CITROMOSEPER/4-zone-irrigation-system-2026-TDK-Project/1000030846.jpg

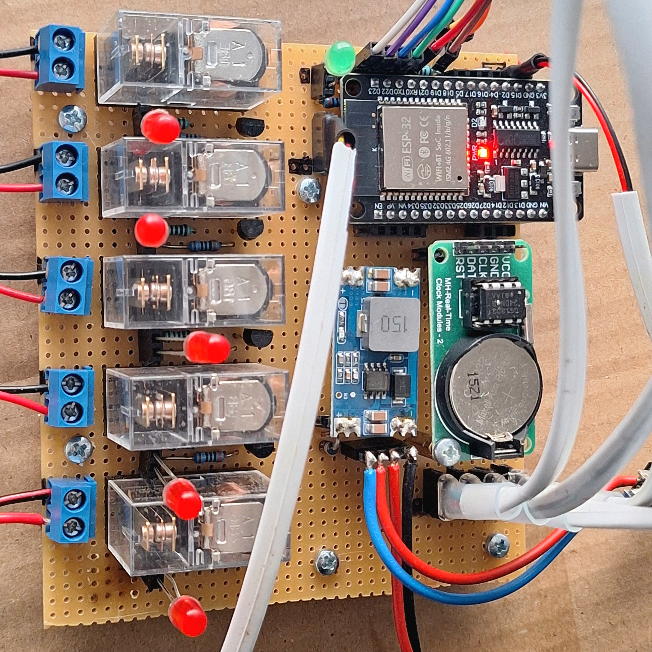
1000030846.jpg
