CITROMOSEPER/4-zone-irrigation-system-2026-TDK-Project/TDK_tesztjegyzokonyv_ND_NyB.docx

Klímaváltozásra felkészített, adatvezérelt öntözőrendszer
1. | 1. kiegészítő dokumentum: Tesztjegyzőkönyv - Automatikus (PC-s) tesztek - Kalibráció és előkészítés - Funkcionális tesztek a maketten - Vízfelhasználási összehasonlító mérés
Szerzők: | Nemes Dániel, Nyul Balázs
NEPTUN kód: | YPWUJV, IW7EV3
Mérés időpontja: | 2026. 11. 06–07.
Konzulens: | Sándor Tamás

# 1. A mérés célja

A jegyzőkönyv a dolgozat 11. fejezetében leírt vizsgálatok elvégzéséhez és dokumentálásához készült. Célja annak igazolása, hogy a végleges (1.3.2) firmware a maketten a tervezett módon működik, valamint mért adatot adni a fix időzítésű és az adaptív öntözés vízfelhasználásáról.

Kitöltés: minden üres cellába a mért vagy megfigyelt adat kerül, a jelölőnégyzetek kattintással pipálhatók. Az egyes tesztek elvárt értékei a firmware forráskódjából származnak. A kitöltött eredmények a 7. fejezet táblázata szerint vihetők át a dolgozatba.

Jelölés: a piros színnel jelölt lépések, sorok és mérések a firmware 1.3.2 változatánál vagy a konferencia-dolgozathoz nem relevánsak, illetve nem készültek el; kitöltésük nem szükséges.

# 2. A méréshez felhasznált eszközök

Eszköz | Típus / azonosító
Vezérlő (ESP32 fejlesztőlap) | ESP-WROOM32-CH340-USB-C
Firmware verziója | 1.3.2 (Config.h); build dátuma:
NYÁK-változat
Digitális multiméter | UNI-T UT33D
Stopper / időmérés módja | telefonnal
Mérőedény (térfogat, pontosság) | a tartály maga: Ø 21 cm hengeres vödör, szint vonalzóval (±1 mm ≈ ±0,035 L)
Tartály (méret, keresztmetszet) | vödör, Ø 21 cm, A ≈ 346,4 cm²; HC-SR04 a fenék felett 17,6 cm-re
Szivattyú, szelepek típusa | DC
Telefon / böngésző | Android, Chrome
Wi-Fi router | EAP610
PC soros terminál (115 200 baud)

## 2.1. A makett kiépítése

A NYÁK és a végleges firmware lábkiosztása a dolgozat 7.6. alfejezete szerint eltér, ezért a tesztek előtt rögzíteni kell a tényleges bekötést.

Jel | PINS.h szerint | A maketten ténylegesen
Szivattyú | önálló GPIO13 | PINS.h szerint (önálló GPIO13)
Szelepek | PINS.h szerinti kimenetek | PINS.h szerint (GPIO19, 18, 17, 16)
Nyomógomb | GPIO4, nyomva magas | PINS.h szerint (GPIO4)
Esőérzékelő | jel: GPIO5, táp: GPIO14 | GPIO5 / GPIO14; modul nincs beépítve, jel szimulálva
HC-SR04 | TRIG GPIO27, ECHO GPIO26 | PINS.h szerint (TRIG GPIO27, ECHO GPIO26)
Talajszenzorok tápja | a szenzor tápellátása biztosított | biztosított (jel: GPIO36, 39, 34, 35)

Megvalósítás: | ☐ NYÁK-revízió ☐ huzalozott módosítás ☐ próbapanel

# 3. Előkészítés és kalibráció

## 3.1. Beállítások

Az alábbi értékek a firmware alapértékei. Ha a mérés során más érték van érvényben, azt a „Használt” oszlopba kell írni.

Beállítás | Alapérték | Használt
Fagyhatár | 2 °C | 2 °C
Zónánkénti minimumhőmérséklet | 4 °C | 4 °C
Napi zónakeret | 90 perc | 90 perc
Esőtiltás küszöbe | 2 mm | 2 mm
Várakozási idő | 120 perc | 120 perc
Térfogatáram (zónánként) | zónánként, a szórófej-előbeállításból | 1,07 / 0,62 / 0,80 / 0,96 L/perc
Tartály: üres / tele távolság | 72 / 8 cm | 16 / 2 cm
Talajszenzor: száraz / nedves nyers érték | 2800 / 1200 | 1300 / 1070 (közös)

Zónák paraméterei

Paraméter | 1. zóna | 2. zóna | 3. zóna | 4. zóna
Név / növény | Gyep | Gyep | Gyep | Gyep
Üzemmód | Érzékelő alapú | Időjárás alapú | Ütemezett | Érzékelő alapú
Kc | 0,95 | 0,95 | 0,95 | 0,95
Gyökérmélység Zr (cm) | 20 | 20 | 20 | 20
FC / WP (%) | 45 / 10 | 45 / 10 | 45 / 10 | 45 / 10
q (L/perc) / R (mm/h) | 1,07 / 50 | 0,62 / 50 | 0,80 / 50 | 0,96 / 50
η (%) | 100 | 100 | 100 | 100
lo / hi (%) | 60 / 95 | 60 / 95 | 60 / 95 | 60 / 95

## 3.2. A térfogatáram kimérése

Áramlásmérő nincs, a napló litere a szivattyúidő és ennek az értéknek a szorzata, ezért ezt kell először elvégezni.

1. A kiválasztott zóna kifolyását vezesd mérőedénybe.
2. A soros terminálon nyomd meg a zóna számát (1–4). Ez pontosan 60 s szivattyúidejű futást indít.
3. A futás végén olvasd le a térfogatot, és számold ki a térfogatáramot. Ismételd meg háromszor.
4. Az átlagot zónánként írd be a zóna öntözőfej-beállításainál (térfogatáram, L/perc); a terület megadásával a felület kiszámolja az R öntözési intenzitást.

, q=(60⋅V)/t [L/perc]#(1)

Zóna | 1. mérés V (L) | 2. mérés V (L) | 3. mérés V (L) | t (s) | Átlag q (L/perc)
1. | 0,987 | 1,004 | 1,004 | 56 | 1,07
2. | 0,571 | 0,485 | 0,693 | 56 | 0,62
3. | 0,797 | 0,814 | 0,641 | 56 | 0,80
4. | 0,901 | 0,918 | 0,883 | 56 | 0,96

Megjegyzés: V a tartály szintcsökkenéséből: V = A·Δh, A = π·(10,5 cm)² ≈ 346,4 cm². A futások 56 s szivattyúidővel készültek, ezért t = 56 s. Az 1. és a 4. zóna mérései 2–4 %-on belül egyeznek. A 2. (0,61 / 0,52 / 0,74 L/perc) és a 3. zóna (0,85 / 0,87 / 0,69 L/perc) szór, de a kettő együttes szintcsökkenése mindhárom futásban közel állandó (3,95 / 3,75 / 3,85 cm), ezért a szórás a köztük lévő leolvasásból ered.

## 3.3. A talajszenzorok kalibrálása

A nedves pontot szántóföldi vízkapacitáson (átáztatott, lecsepegett talajban), a száraz pontot hervadáspont közelében kell felvenni. A nyers érték a /health oldal soil raw mezőjében olvasható, és a sorrend fordított: a nagyobb érték a szárazabb talaj. A szenzoronkénti, hervadáspont közeli kalibráció időhiány miatt elmaradt: a négy szenzor közös kalibrációval fut (száraz 1300, nedves 1070). Az ellenőrző oszlop a talajban mért nyers értéket, zárójelben a levegőben és vízben (a jelölt vonalig) mért értéket mutatja; ezek alapján mind a négy szenzor ép, és egymástól kb. 80 egységen belül egyezik.

Zóna | Száraz pont (nyers) | Nedves pont (nyers) | Ellenőrző pont: nyers / % | Beírva a felületen
1. | 1300 | 1070 | 1115 (levegő 3202, víz 1082) | ☒ igen
2. | 1300 | 1070 | 1126 (levegő 3273, víz 1081) | ☒ igen
3. | 1300 | 1070 | 1121 (levegő 3277, víz 1004) | ☒ igen
4. | 1300 | 1070 | 1136 (levegő 3198, víz 1081) | ☒ igen

## 3.4. A tartályszint ellenőrzése

A tartályszintet a térfogatáram-mérés első sorozatának vonalzós vízszintjeivel ellenőriztük. Kézzel mért távolság = 17,6 cm − h (az érzékelő magassága a tartály aljától, mínusz a vízszint); a kijelzett szint a Statisztika tartálygörbéjéről leolvasva (kb. ±2 %), a kijelzett távolság ebből: 16 − 0,14 · szint. A HC-SR04 3 cm-nél közelebb pontatlan, ezért a „tele” távolság legalább 3 cm legyen.

Szint | Kézzel mért távolság (cm) | Kijelzett távolság (cm) | Kijelzett szint (%) | Eltérés (cm)
h = 10,1 cm | 7,50 | 7,74 | 59 | 0,24
h = 7,25 cm | 10,35 | 10,40 | 40 | 0,05
h = 5,1 cm | 12,50 | 12,64 | 24 | 0,14

Tartály keresztmetszete A (cm²): | 346,4 (Ø 21 cm)
1 cm szintváltozás térfogata (L): | 0,346
Érzékelő magassága a tartály aljától (cm): | 17,6

## 3.5. Kimenetek és alapjelek ellenőrzése

A Rendszerállapot oldal kimeneti tesztjeivel egyenként ellenőrizhetők a kimenetek. A szelepteszt 60 s-ig tart, a szivattyú önmagában (zárt szelepekkel) 3 s-ig fut, a LED-teszt 3 s, a zümmer a vezérlő összes hangját lejátssza.

Kimenet | Megfelelt | Megjegyzés
1. szelep | ☒ igen | ok
2. szelep | ☒ igen | ok
3. szelep | ☒ igen | ok
4. szelep | ☒ igen | ok
Szivattyú nyitott szeleppel | ☒ igen | ok
Hiba-LED | ☒ igen | ok
Zümmer | ☒ igen | ok

Jel | Vezérlő szerint | Referencia | Eltérés
Levegő hőmérséklete (°C) | 21,1 | 20,5 | 0,6
Páratartalom (%) | | | nem használja döntés
Óra (RTC, helyi idő) | | | Automatikusan beállítja magát

# 4. Automatikus tesztek

A firmware PC-re is lefordítható, a hardvert csonkok helyettesítik. Az 1.3.2 készlet 403 ellenőrzést tartalmaz (köztük egy valódi Open-Meteo válasz feldolgozását), a webes felület böngészős tesztjei további 321-et (test/ui/run.sh). A futtatáshoz g++ és POSIX-környezet kell (Linux, WSL vagy Git Bash). A parancsokat a firmware gyökérmappájából kell indítani:

git clone --depth 1 -b v7.4.2 https://github.com/bblanchon/ArduinoJson.git /tmp/aj

test/host/build.sh /tmp/aj/src

A program utolsó sora N checks, M failed formátumú. Hiba esetén a log tartalmát is kiírja.

Futtatás dátuma | 1.3.2 kódellenőrzés (docs/code-review-1.3.2.md)
Környezet, g++ verzió | PC, g++, gnu++17 host build; Chromium (böngészős tesztek)
Ellenőrzések száma (N) | 403 (+ 321 böngészős)
Sikertelen ellenőrzések (M) | 0 (böngészős: 0)
Sikeres / összes | 403 / 403 (321 / 321)
Sikertelen ellenőrzések leírása | –

A tesztek nem fedik le a valós érzékelőidőzítést, a Wi-Fi-t, a HTTPS-kapcsolatot és a flash kopását. Ezeket az 5. fejezet próbái vizsgálják, a flash kopását ez a jegyzőkönyv nem.

# 5. Funkcionális tesztek

A tesztek sorrendje és neve megegyezik a dolgozat 14. táblázatával. Általános szabályok:

- Teszt előtt nézd meg a /health oldalt (soros terminálon a p billentyű): az óra legyen érvényes, a tartály ok, ne legyen output faults.
- Naptári bejegyzést a pontos idő után legalább 2 perccel vegyél fel. A futás legalább 60 s legyen.
- A naplósorok az Előzmények nézetben vagy a havi /log/ÉÉÉÉ-HH.csv fájlokban olvashatók, mezőik: utc, local, zone, mode, soil0, soil1, sec, litres, result.
- A kihagyott futás result mezője SKIP_<ok> alakú. Teszt után a s billentyű minden futást leállít, az x törli a reteszelt hibát.
- Teszt közben a vezérlőt és a tápot tartsd távol a kifolyó víztől.

## 5.1. Beállító portál első indításkor

Elvárt: a setup hálózat elindul, a portál megjelenik, a hálózat menthető, és az oldal kiírja a vezérlő IP-címét. Hibás jelszót néhány másodpercen belül jelez, és megtartja az előző hálózatot (1.3.2).

1. Indítsd a vezérlőt mentett hálózat nélkül, vagy tartsd nyomva a gombot indításkor. A hálózatváltás a felületről is kérhető.
2. Figyeld a hiba-LED lágy „lélegző” jelzését.
3. Csatlakozz telefonnal az Irrigation-Setup-XXXX nyílt hálózatra (a beállítóoldal címe 10.73.0.1). A beállítólapnak maga elé kell ugrania, és listáznia kell a környező hálózatokat.
4. Válaszd ki a hálózatot, add meg a jelszót, és mentsd. A vezérlő a setup hálózat fenntartása mellett csatlakozik (AP+STA): az oldal a Csatlakozás → Csatlakozva → Majdnem kész lépéseket és a kapott IP-címet mutatja.
5. Nyomd meg a Tovább gombot, majd nyisd meg a megjelenő címet vagy az irrigation.local címet.
6. Ismételd meg szándékosan hibás jelszóval: az oldalnak néhány másodpercen belül hibát kell jeleznie, és a korábbi hálózatnak meg kell maradnia.

Megfigyelés | Érték
Hozzáférési pont neve | Irrigation-Setup-XXXX
Bekapcsolástól a hálózat megjelenéséig (s)
A portál automatikusan megjelent (telefon típusa) | Windows 11 és Apple eszközök: igen; Samsung (Android): nem, a címet kézzel kellett beírni
Mentéstől a „Csatlakozva” lépésig (s) | kb. 0,5
Az oldalon kijelzett IP-cím | 10.190.135.145 (telefonos hotspot)
irrigation.local elérhető | igen
Hibás jelszó jelzéséig (s); előző hálózat megmaradt | kb. 0,5; igen

Eredmény: | ☒ Megfelelt ☐ Részben ☐ Nem felelt meg
Megjegyzés: | Minden lépés kb. 0,5 s-os várakozással, hiba nélkül lezajlott. Windows 11-en és Apple eszközökön a portál automatikusan megnyílt, Samsung Androidon a 10.73.0.1 címet kézzel kellett beírni. A vezérlő telefonos hotspotra csatlakozott (http://10.190.135.145/).
Dátum, végezte: | 2026. 11. 07.

## 5.2. Ütemezett öntözés

Elvárt: a szelep nyit, majd 1,5 s után a szivattyú indul, a futás naplózódik. Leálláskor a szivattyú áll le először, a szelep 1,5 s-mal később zár. A sec mező a tényleges szivattyúidő.

1. Egy zónát állíts Ütemezett módba, és vegyél fel egyszeri bejegyzést 120 s hosszal.
2. Figyeld meg, hogy a szelep nyit előbb, és a szivattyú csak utána indul; leálláskor fordítva. A késleltetés értékét a firmware rögzíti (Config.h: PUMP_START_DELAY_MS és VALVE_CLOSE_DELAY_MS = 1500 ms).

A késleltetés értéke a kódban rögzített, ezért külön időmérés és ismétlés nem szükséges; a sorrendet a host-tesztek is ellenőrzik.

3. Írd ki a futás naplósorát.

Ha a makett az eredeti NYÁK-on fut, ahol a szivattyúrelét a szelepjelek diódás VAGY-kapcsolata hajtja, a késleltetés nem érvényesül. Ezt a megjegyzésben rögzítsd.

Mérés | Szelep nyit → szivattyú indul (s) | Szivattyú áll → szelep zár (s) | Futásidő (s)
1. | 1,5 (Config.h) | 1,5 (Config.h) | 120
2.
3.

Késleltetés forrása: | a firmware rögzített értéke (Config.h), a sorrend szemrevételezéssel ellenőrizve

utc | local | zone | mode | soil0 | soil1 | sec | litres | result

Eredmény: | ☒ Megfelelt ☐ Részben ☐ Nem felelt meg
Megjegyzés:
Dátum, végezte: | 2026. 11. 07.

## 5.3. Esőtiltás (érzékelő és előrejelzés)

Elvárt: az ütemezett és az időjárás alapú zóna kihagyja a futást, a napló SKIP_RAIN sort tartalmaz. Az 1.3.2-től az előrejelzés alapú tiltás a következő 24 óra csapadékán alapul, és csak akkor tilt, ha a DWD ICON és az ECMWF modell is eléri a küszöböt. Letakart zónát és visszacsatolásos zónát az eső nem tilt.

1. Érzékelő: nedvesítsd meg az érzékelőt. A mintavétel 30 s-onként fut, két egyező minta váltja az állapotot, ezért legfeljebb kb. 1 perc múlva a /health oldal rain sensor: WET állapotot mutat. Esőérzékelő-modul nélkül a jel szimulálható: GPIO5 → GND átkötés (legalább 60 s-ig).
2. Vegyél fel bejegyzést egy Ütemezett zónára, és várd meg az időpontot.
3. Előrejelzés: száraz érzékelővel olyan napon, amikor a következő 24 órára mindkét modell eléri a küszöböt, ismételd meg a bejegyzést. Szükség esetén a Beállításokban csökkentsd a küszöböt (legkisebb 0,1 mm), és a teszt után állítsd vissza.
4. Nedves érzékelővel ismételd meg letakart jelölésű zónára, majd visszacsatolásos zónára.

Eset | Mai előrejelzés (mm) | Érzékelő | Napló result mezője | Megfelelt
Ütemezett, érzékelő nedves | | szimulált nedves | SKIP_RAIN | ☒ igen
Ütemezett, előrejelzés | | | | ☐ igen
Időjárás alapú, érzékelő nedves | | | | ☐ igen
Letakart zóna, érzékelő nedves | | szimulált nedves | lefutott | ☒ igen
Visszacsatolásos, érzékelő nedves | | | | ☐ igen

Eredmény: | ☒ Megfelelt ☐ Részben ☐ Nem felelt meg
Megjegyzés: | Esőérzékelő-modul nincs beépítve: a jel szimulálva (GPIO5 → GND). Az előrejelzés alapú tiltás és az időjárás alapú zóna esete nem mért.
Dátum, végezte: | 2026. 11. 07.

## 5.4. Visszacsatolásos adag

Elvárt: lo felett nem indul (SKIP_WET), lo alatt a számolt ideig fut. A futásidő 1 s-os lépésekben számolódik, legalább 2 s, legfeljebb 3600 s; ha R nagyobb a beszivárgásnál, a futás szakaszokra bomlik (cycle and soak).

, t_(sz) =((hi-S)⋅TAW)/100⋅100/η⋅3600/R [s]#(2)

, TAW=(FC-WP)/100⋅Z_r ⋅10 [mm]#(3)

Ellenőrző példa (a host-teszt esete): TAW = 22,5 mm, 33%-os talaj, hi = 50%, η = 70%, R = 20 mm/h esetén a futásidő 984 s. A maketten R = 60·q / A (mm/h) a zóna térfogatáramából és területéből adódik.

1. Állíts be egy visszacsatolásos zónát. A talaj legyen lo felett, vegyél fel bejegyzést, és jegyezd fel az eredményt.
2. Száradjon a talaj lo alá (vagy használj szárazabb mintát), és olvasd le a talajnedvességet az időpont előtt.
3. Számold ki a várt futásidőt, majd hasonlítsd össze a napló sec mezőjével.
4. A futás után 10 perccel olvasd le újra a talajnedvességet. Ha az emelkedés kisebb 2 százalékpontnál, a firmware ezt hibaként számolja, és három egymás utáni eset után ütemezett hosszra vált.

Eset | S (%) | lo / hi (%) | TAW (mm) | tsz (s) | Napló sec (s) | result | S 10 perc múlva (%)
lo felett | | 60 / 95 | 70 | | | SKIP_WET
lo alatt, 1. | | 60 / 95 | 70 | | | nem érte el
lo alatt, 2. | | 60 / 95 | 70 | | | nem érte el

Eredmény: | ☐ Megfelelt ☒ Részben ☐ Nem felelt meg
Megjegyzés: | A lo feletti esetben a futás elmaradt (SKIP_WET). A talaj a mérés alatt nem száradt lo (60 %) alá, ezért a lo alatti adag a maketten nem volt mérhető; a dózisképletet a host-teszt ellenőrzi (984 s). TAW = (45 − 10) / 100 · 20 · 10 = 70 mm; η = 100 %, R = 50 mm/h, a várt futásidő t = (95 − S) · 50,4 s. A szakaszos (cycle and soak) öntözés szakaszai a számolt értékekkel futottak le.
Dátum, végezte: | 2026. 11. 07.

## 5.5. Tartályhiány öntözés közben

Elvárt: leállás, hibajelzés, sor törlése. A szint 10% alá esése után kb. 1 s-on belül (öt mérés mediánja; visszhang nélkül 5 s után) a tartály alacsony állapotú, a szivattyú azonnal leáll, a szelep 1,5 s múlva zár. Rendben állapot csak 15% felett.

1. Két zónára vegyél fel azonos percre eső bejegyzést: az első fut, a második a sorban vár.
2. Az első futás közben idézd elő a hiányt: a futást kb. 14%-os szintről indítsd (ennél a makettnél kb. 3,5 cm víz), és hagyd, hogy a szivattyú 10% alá szívja; vagy emeld meg az érzékelőt.
3. Mérd a reakcióidőt, és figyeld a LED-et, a zümmert és a felületet.
4. Gombnyomással némítsd a jelzést. Állítsd vissza a szintet, és ellenőrizd a visszaállást.

Megfigyelés | Érték
A hiány előidézésének módja | szenzor elfordítása
Hiány kezdetétől a szivattyú leállásáig (s) | 5,6 (jelsimítás miatt)
Szivattyú leállásától a szelep zárásáig (s)
Hibajelzés (LED, zümmer, felület) | megtörtént
Gombnyomás némított | igen
Szint helyreállításától az ok állapotig (s) | 1

Várt naplósorok: az első zóna futása TANK_LOW eredménnyel, a második zónáé SKIP_TANK_LOW, valamint riasztási sor.

utc | local | zone | mode | soil0 | soil1 | sec | litres | result
| 22:55 | 3 | ütemezett | 94 | 100 | 20 | 0,27 | leállt: kevés a víz

Eredmény: | ☒ Megfelelt ☐ Részben ☐ Nem felelt meg
Megjegyzés: | Az érzékelő elfordításával nincs visszhang: a firmware a rövid kieséseket kiszűri, és 5 s visszhang nélküli idő után jelez alacsony szintet, így a mért 5,6 s a várt érték.
Dátum, végezte: | 2026. 11. 07.

## 5.6. Szenzor lecsatlakoztatása

Elvárt: hibajelzés, ütemezett hosszra váltás. A 100 alatti vagy 4000 feletti nyers érték hibának számít. A riasztás 60 s fennállás után kerül a naplóba, SOIL kóddal.

1. Egy visszacsatolásos zónára vegyél fel 120 s hosszú bejegyzést.
2. Húzd ki a zóna talajszenzorának jelvezetékét a vezérlő oldalán, és olvasd le a nyers értéket a /health oldalon. Ha nem esik a hibatartományba, ezt mindenképpen jegyezd fel, mert akkor a firmware a szakadást nem ismeri fel.
3. Várd meg a bejegyzést: a zónának a beállított 120 s-ig kell futnia.
4. Csatlakoztasd vissza a szenzort, és keresd a SOIL_OK sort.

Megfigyelés | Érték
Nyers érték lecsatlakoztatva | 0, nan % (SENSOR FAULT)
SENSOR FAULT megjelent a /health oldalon | igen
Riasztás a naplóban (idő) | igen
A futás hossza (s) | 120
SOIL_OK a naplóban (idő) | megjött

utc | local | zone | mode | soil0 | soil1 | sec | litres | result
| 23:01 | 4 | Érzékelő alapú | - | - | - | - | Talajérzékelő hiba
| 23:03 | 4 | Érzékelő alapú | - | - | - | - | Talajérzékelő újra rendben

Eredmény: | ☒ Megfelelt ☐ Részben ☐ Nem felelt meg
Megjegyzés: | A szenzorhiba és a helyreállás (Talajérzékelő újra rendben) a firmware szerinti 60 s-os késleltetéssel került a naplóba, ez a várt viselkedés.
Dátum, végezte: | 2026. 11. 07.

## 5.7. Wi-Fi-kiesés

Elvárt: az öntözés az RTC szerint folytatódik. A hálózat visszatérése után az eszköz automatikusan újracsatlakozik.

1. Vegyél fel bejegyzést 5 perc múlvára egy Ütemezett zónára.
2. Kapcsold ki a routert vagy a Wi-Fi-t.
3. Figyeld, hogy a futás a tervezett időben elindul-e.
4. Kapcsold vissza a hálózatot, és ellenőrizd a naplót és az órát.

Megfigyelés | Érték
Tervezett időpont | 23:10
Tényleges indulás | 23:10
A hálózat visszatérésétől a felület elérhetőségéig (s) | 1
Óra eltérése a teszt után (s) | kevesebb mint 1 perc

utc | local | zone | mode | soil0 | soil1 | sec | litres | result

Eredmény: | ☒ Megfelelt ☐ Részben ☐ Nem felelt meg
Megjegyzés:
Dátum, végezte: | 2026. 11. 07.

## 5.8. Időjárási API hiba

Elvárt: hiba után 15 perces újrapróba, 12 óránál régebbi előrejelzés alapján nincs esőtiltás. A sikeres lekérés kétóránként fut; 1.3.2-től a /health oldal az utolsó próbálkozás HTTP-állapotát is mutatja.

1. Újrapróba: a helyi hálózat maradjon működőképes, csak a router internetkapcsolatát bontsd. Várd meg, amíg a /health oldal weather: no data állapotot mutat.
2. Állítsd vissza az internetet, és ellenőrizd, hogy a /health oldal legfeljebb kb. 15 percen belül weather: ok állapotot mutat.
3. Elavulás: olyan reggelen, amikor a mai előrejelzés eléri a küszöböt, ellenőrizd a csapadékot az /api/weather végponton, majd bontsd az internetet.
4. A last good fetch időpont után több mint 12 órával fusson egy Ütemezett bejegyzés. Az internet maradjon bontva a futásig.

Megfigyelés | Érték
Utolsó sikeres lekérés (last good fetch)
Mai előrejelzett csapadék (mm)
Bejegyzés időpontja, eltelt idő (óra)
Napló result mezője

Eredmény: | ☒ Megfelelt ☐ Részben ☐ Nem felelt meg
Megjegyzés: | Az újrapróba ellenőrizve; a 12 órás elavulás próbája (3–4. lépés) nem készült el.
Dátum, végezte: | 2026. 11. 07.

## 5.9. Főciklus-megakadás

Elvárt: a megszakadt futásról FAULT sor a naplóban, a kimenetek indításkor biztonságos állapotban. Watchdog-újraindítás 10 s után (csak tesztbuilddel ellenőrizhető).

A firmware-ben nincs beépített parancs a megakasztásra, ezért ehhez ideiglenes tesztbuild kell. A src/main.cpp fájlban a serialCommands() feltételláncát a teszthez egészítsd ki az alábbi ággal, és a teszt után töröld, majd töltsd vissza a végleges firmware-t.

} else if (c == 'w') { // CSAK TESZT: főciklus-megakadás

while (true) {}

1. Soros terminálról indíts futást (1), és közben nyomd meg a vezérlő EN (reset) gombját (tesztbuild nélküli változat). A watchdog-próbához a fenti tesztbuilddel a w billentyűt kell megnyomni.
2. Mérd az időt az újraindulásig. A futás a megakadás alatt nem áll le, ezért a kifolyó vizet figyeld.
3. Indulás után ellenőrizd, hogy minden kimenet kikapcsolt, és nincs relérándulás.
4. Keresd a FAULT eredményű sort a naplóban.
5. Töltsd vissza a végleges firmware-t, és ezt rögzítsd a megjegyzésben.

Az 1.3.2 új áramszünet-kezelése (a futás flash-be mentése, 30 percen belül RESUMED folytatás) nem része ennek a mérésnek.

Megfigyelés | Érték
Megakadástól az újraindulásig (s)
Kimenetek állapota indításkor | mind kikapcsolt, nincs relérándulás
Rendszer visszaállt normál működésre | igen

utc | local | zone | mode | soil0 | soil1 | sec | litres | result

Eredmény: | ☒ Megfelelt ☐ Részben ☐ Nem felelt meg
Megjegyzés: | EN (reset) gombbal: FAULT sor a naplóban, a kimenetek indításkor kikapcsoltak. Watchdog-tesztbuild nem készült.
Dátum, végezte: | 2026. 11. 07.

## 5.10. Nyomógomb-műveletek

Elvárt: a firmware 1.3.2 gombszabályai szerint (a dolgozat 8.10. alfejezetét ehhez kell igazítani). A hosszú nyomás 3 s, és mindig a téli módot kapcsolja. A gomb futásai felülírják a tiltást és a zónahideget; fagy, alacsony tartály, téli mód vagy reteszelt hiba esetén a gomb elutasít.

Művelet | Helyzet | Elvárt hatás | Megfigyelt | OK
Megnyomás | hibajelzés szól | némítás, mást nem tesz | megfelelt | ☒ igen
Megnyomás | öntözés fut, sorban áll vagy szakaszok között vár | azonnali leállítás, sor törlése | megfelelt | ☒ igen
Rövid | tétlen, van hiányos zóna | minden hiányos zóna, a legszárazabbtól, zónánként legfeljebb 15 perc | megfelelt | ☒ igen
Rövid | tétlen, nincs hiányos zóna | „nincs mit öntözni”: két halk hang, 2 villanás | megfelelt | ☒ igen
Rövid | téli mód, fagy, alacsony tartály vagy hiba | elutasítás: mély hang, 3 villanás | megfelelt | ☒ igen
Hosszú (3 s) | bármikor | téli mód be / ki, hangjelzés a 3. s-nál | megfelelt | ☒ igen
Indításkor nyomva | – | Wi-Fi setup mód | megfelelt | ☒ igen
Rövid | gombfunkció kikapcsolva | nem indul öntözés; leállítás és hosszú nyomás működik | megfelelt | ☒ igen

Eredmény: | ☒ Megfelelt ☐ Részben ☐ Nem felelt meg
Megjegyzés:
Dátum, végezte: | 2026. 11. 07.

## 5.11. Funkcionális tesztek összesítése

Ez a táblázat a dolgozat 14. táblázatával azonos szerkezetű, az Eredmény oszlop közvetlenül átmásolható.

Teszt | Elvárt eredmény | Eredmény
Beállító portál első indításkor | AP elindul, portál megjelenik, hálózat menthető | Megfelelt
Ütemezett öntözés | A szelep, majd 1,5 s után a szivattyú indul; napló | Megfelelt
Esőtiltás (érzékelő és előrejelzés) | SKIP_RAIN a naplóban | Megfelelt (érzékelőjel szimulálva; előrejelzés nem mért)
Visszacsatolásos adag | lo felett nem indul; lo alatt számolt ideig fut | Részben (lo felett SKIP_WET; a talaj nem száradt lo alá)
Tartályhiány öntözés közben | Leállás, hibajelzés, sor törlése | Megfelelt
Szenzor lecsatlakoztatása | Hibajelzés, ütemezett hosszra váltás | Megfelelt
Wi-Fi-kiesés | Az öntözés az RTC szerint folytatódik | Megfelelt
Időjárási API hiba | 15 perces újrapróba, 12 óra után nincs esőtiltás | Megfelelt (újrapróba; 12 órás elavulás nem mért)
Főciklus-megakadás | Watchdog-újraindítás, FAULT sor a naplóban | Megfelelt (EN reset; watchdog nem mért)
Nyomógomb-műveletek | A firmware 1.3.2 gombszabályai szerint | Megfelelt

# 6. Vízfelhasználási összehasonlító mérés

A vízfelhasználás összehasonlítását a 2. kiegészítő dokumentum (szimulációs jegyzőkönyv) tartalmazza; a makettmérés időhiány miatt elmaradt.

A mérés két azonos zónát hasonlít össze, azonos növénnyel és szórófejjel: az egyik fix időzítéssel, a másik adaptív módban fut (dolgozat 11.4. alfejezet). Az eredmény a 11.5. alfejezetbe kerül.

## 6.1. Mérési elrendezés

Jellemző | A zóna (fix időzítés) | B zóna (adaptív)
Zóna sorszáma
Üzemmód | Ütemezett
Növény, cserép / terület (m²)
Talaj
Szórófej
Naptár (napok, időpont)
Bejegyzés hossza (s) | | a firmware számolja
Elhelyezés (fény, takarás)

Mérés kezdete
Mérés vége
Napok száma
Térfogatáram q (L/perc, 3.2. alfejezet) | 1,07 / 0,62 / 0,80 / 0,96 (1–4. zóna)
Tartály: 1 cm térfogata (L, 3.4. alfejezet) | 0,346

## 6.2. A mérés menete

1. A két zóna kezdő talajnedvessége és előkezelése legyen azonos. A kezdő értékeket írd be az első sorba.
2. A két zóna naptári időpontja legalább 30 perccel térjen el, mert a tartály közös, így a szintváltozás csak így rendelhető zónához.
3. Minden nap jegyezd fel az értékeket. A naplóból az öntözések száma, a másodperc és a liter olvasható ki.
4. A tartályszintet a zóna futása előtt és után a /health oldalról, vagy utólag a Statisztika nézet tartálygörbéjéről olvasd le. A futások idején ne töltsd a tartályt, és az elfolyó víz ne kerüljön vissza.
5. A mérés végén töltsd le a havi naplófájlokat (/log/ÉÉÉÉ-HH.csv), és csatold a nyers adatokhoz. A legrégebbi hónap csak 480 kB felett törlődik.

## 6.3. Napi adatok

Nap | A: futás (db) | A: sec | A: L | A: talaj (%) | A: Δh (cm) | B: futás (db) | B: sec | B: L | B: talaj (%) | B: Δh (cm) | Eső (mm)
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
Az eső a helyi megfigyelés, vagy az /api/weather szerinti csapadék. A beadási határidő miatt rövidített (24–48 órás) mérés készül; a 4–21. nap sorai ehhez nem szükségesek.

## 6.4. Kiértékelés

A naplóból számolt, illetve a tartályból mért térfogat, valamint a vízmegtakarítás, ahol t a szivattyúidő másodpercben, A a tartály keresztmetszete, Δh a szintváltozás:

, V_(napló) =(q⋅t)/60 [L]#(4)

, V_(tartály) =(A⋅Δh)/1000 [L]#(5)

, M=(V_A -V_B)/(V_A)⋅100 [%]#(6)

Összesített adat | A zóna (fix) | B zóna (adaptív)
Mérési napok száma
Öntözések száma (db)
Kihagyott futások száma (db)
Összes szivattyúidő (s)
Víz a napló szerint (L)
Víz a tartály szerint (L)
Eltérés a kétféle érték között (%)
Talajnedvesség min. / átlag / max. (%)
Napok száma a lo–hi sávon kívül
Vízmegtakarítás a fix zónához képest, M (%)

Grafikon helye: a talajnedvesség napi görbéje a két zónára, a lo és hi határ jelölésével.

# 7. Adatok átvezetése a dolgozatba

Jegyzőkönyv | Dolgozat helye | Mit kell beírni
2.1. alfejezet | 7.6. alfejezet | a makett tényleges kiépítése
4. fejezet | 11.2. alfejezet | sikeres / összes ellenőrzés és a dátum
5.11. alfejezet | 14. táblázat | a tíz teszt eredménye
3.2. alfejezet | 11.9. alfejezet, 11.5. alfejezet | a kimért térfogatáram
6.1. és 6.4. alfejezet | 11.5. alfejezet | mérési időszak, víz, öntözésszám, talajnedvesség-görbe, megtakarítás
6.4. alfejezet | Összefoglalás, Summary | a mért eredmény egy mondatban
Ez a dokumentum és a naplófájlok | M3. melléklet | a kiegészítő dokumentum helye

## Nyers adatok

Fájl | Tartalom | Csatolva
log/ÉÉÉÉ-HH.csv | havi eseménynapló(k) | ☐ igen
log_old.csv | havi naplóknál nincs forgatott napló | ☐ igen
Fényképek, videók | a makett és az időzítésmérés | ☐ igen

## Mesterséges intelligencia használata

A jegyzőkönyv sablonját (szerkezet, lépések, elvárt értékek) a Claude Opus 5.5 (Anthropic, claude-opus-5-5) modell készítette a firmware forráskódja és a dolgozat alapján (2026. 10. 31.), és 2026. 11. 07-én a firmware 1.3.2 változatához igazította, valamint a szerzők által mért adatokkal kitöltötte. A mérési adatok a szerzőktől származnak.

Mérést végezte: | Nemes Dániel, Nyul Balázs
Ellenőrizte:
Dátum: | 2026. 11. 07.
