CITROMOSEPER/4-zone-irrigation-system-2026-TDK-Project/Rendszertervek/Fizikai rendszerterv.png

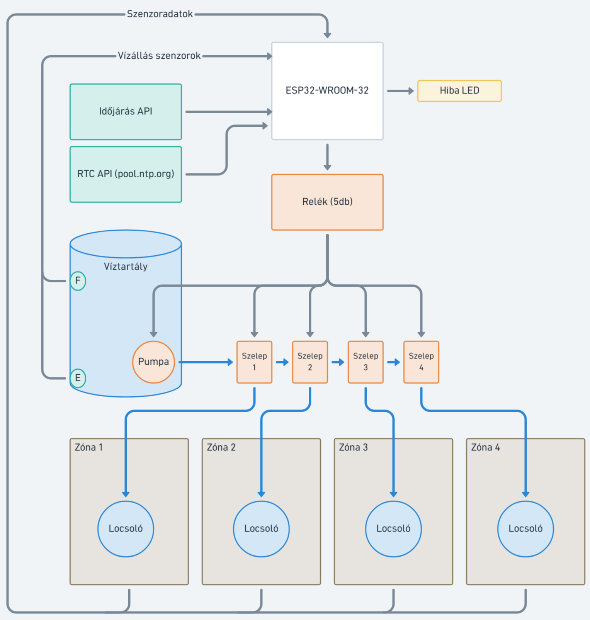
Rendszertervek/Fizikai rendszerterv.png
