CITROMOSEPER/4-zone-irrigation-system-2026-TDK-Project/Rendszertervek/Logikai rendszerterv.png

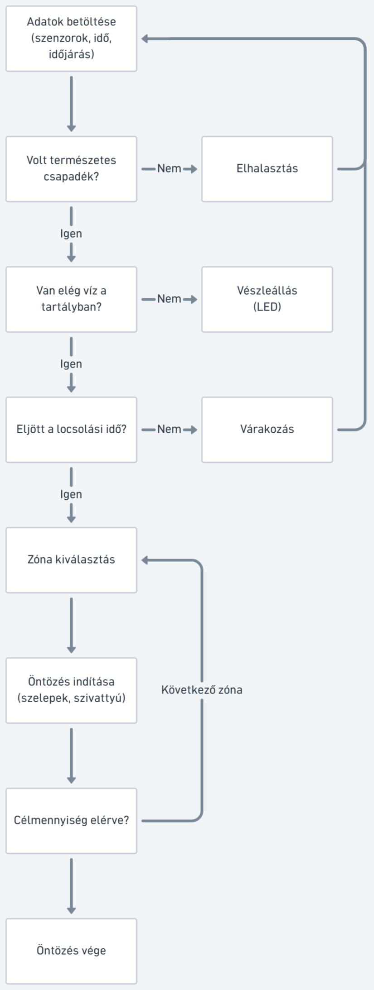
Rendszertervek/Logikai rendszerterv.png
