CITROMOSEPER/4-zone-irrigation-system-2026-TDK-Project/(list of files, drawings)

Other design files:
Áramkör/Öntözőberendezés/sch_data.json
