CITROMOSEPER/4-zone-irrigation-system-2026-TDK-Project/Áramkör/Öntözőberendezés/Öntözőberendezés.kicad_pcb

## KiCad design Áramkör/Öntözőberendezés/Öntözőberendezés.kicad_pcb (2026-11-01)

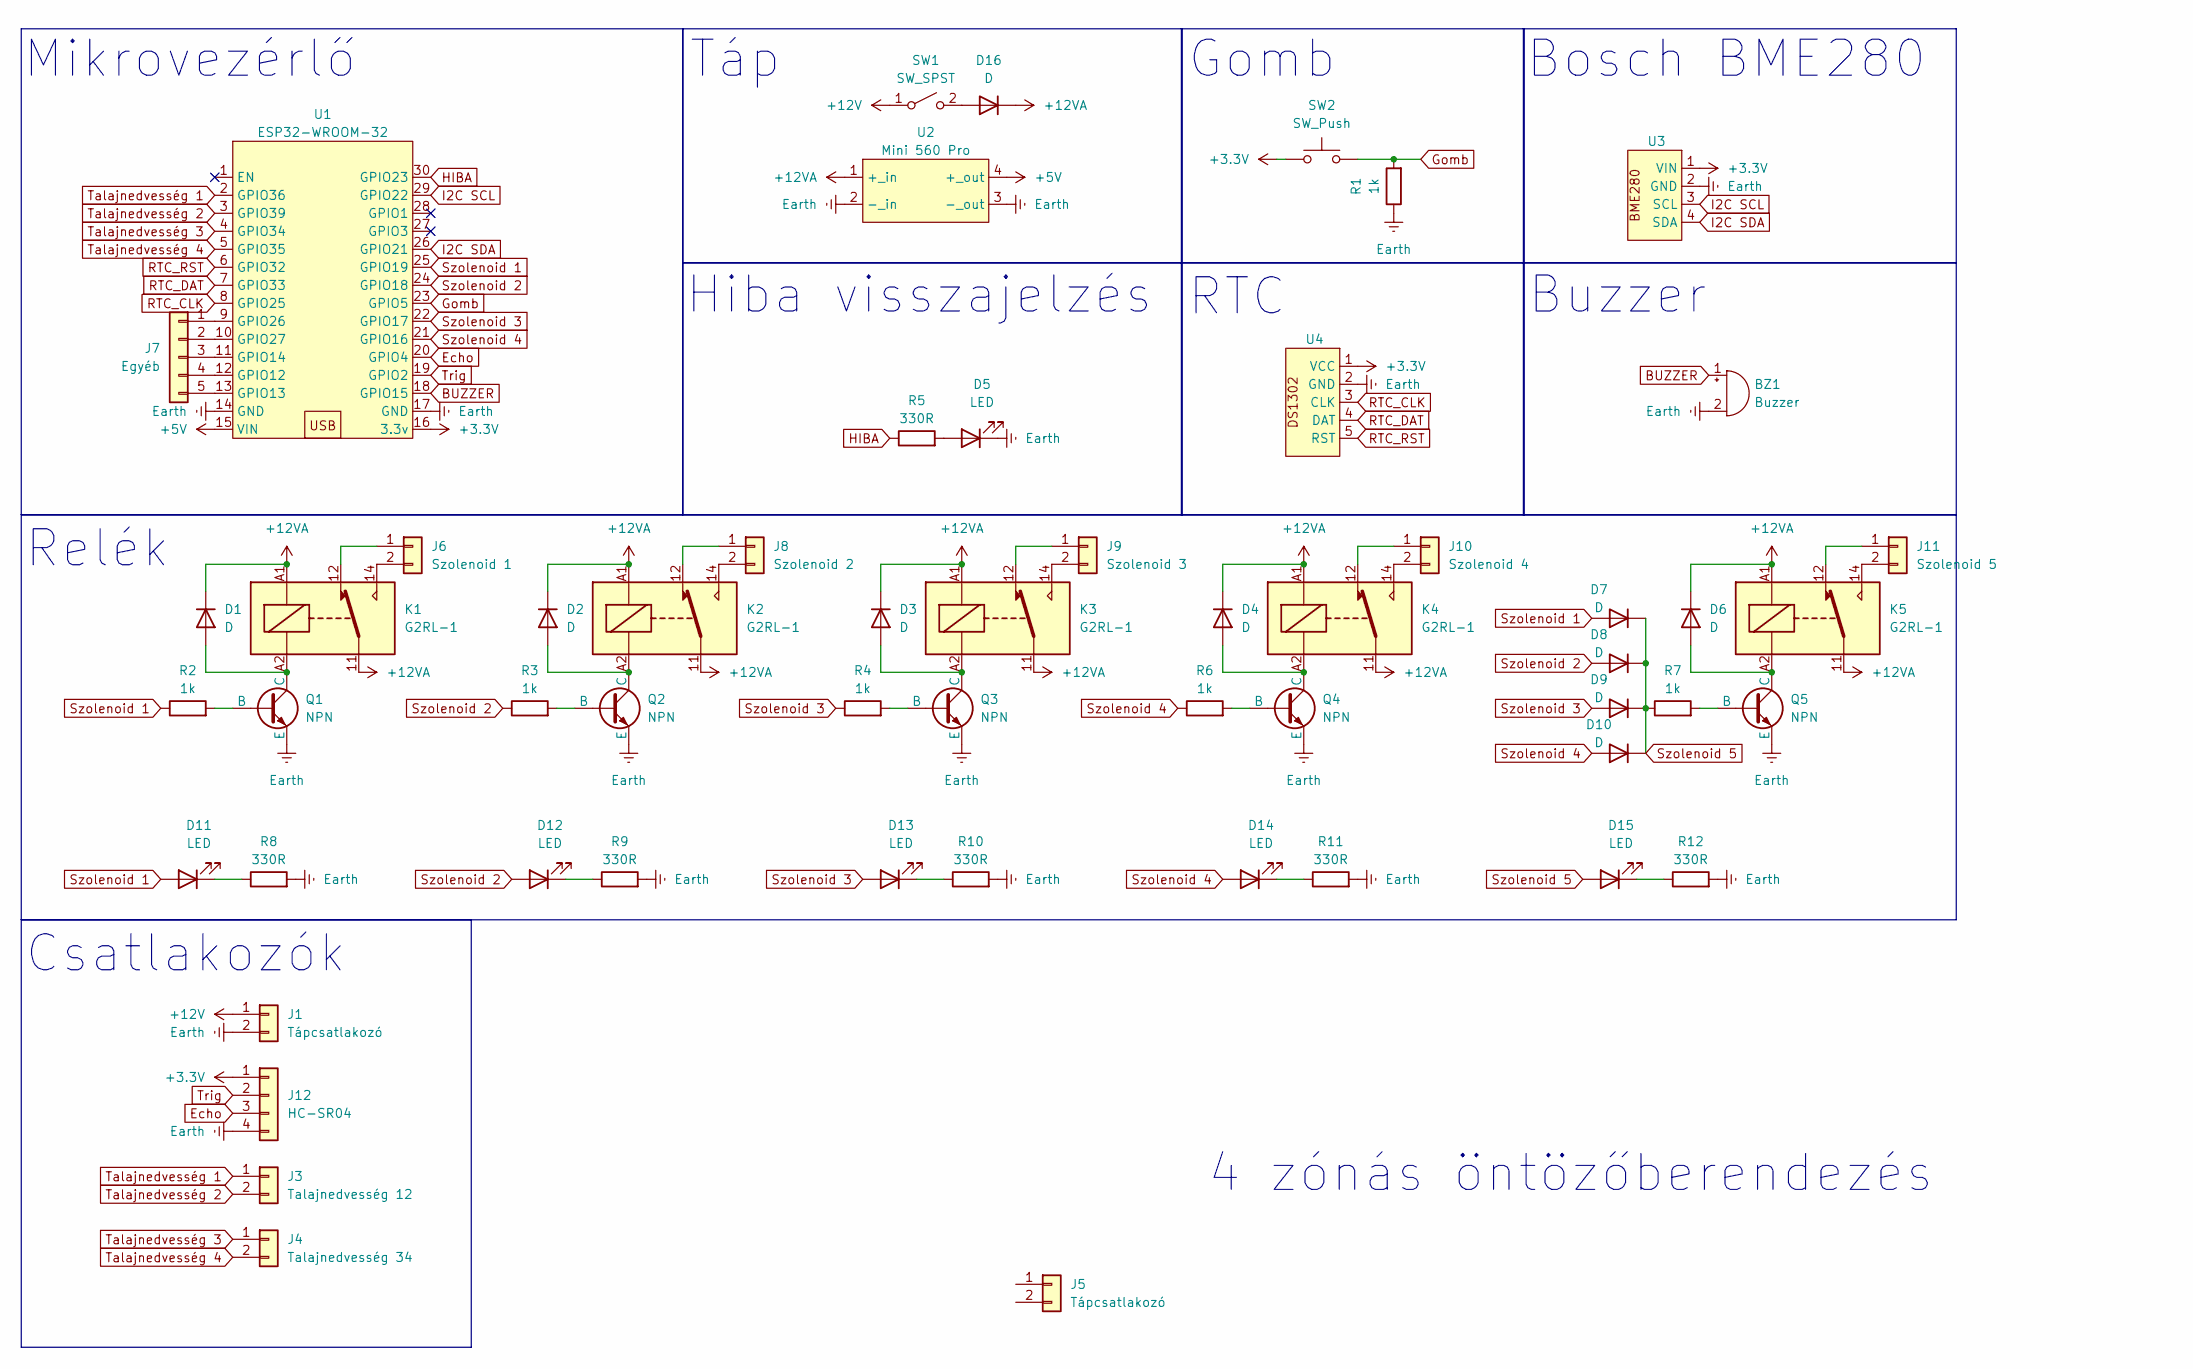
[picture p23: schematic Öntözőberendezés.kicad_sch]

Parts:
BZ1: Buzzer; Passive buzzer 17mm
D1, D2, D3, D4, D6, D7, D8, D9, D10: D; D_DO-41_SOD81_P10.16mm_Horizontal
D5, D11, D12, D13, D14, D15: LED; PinHeader_1x02_P2.54mm_Vertical
D16: D; D_DO-41_SOD81_P2.54mm_Vertical_KathodeUp
J1: Tápcsatlakozó; PinHeader_1x02_P2.54mm_Vertical
J3: Talajnedvesség 12; PinHeader_1x02_P2.54mm_Vertical
J4: Talajnedvesség 34; PinHeader_1x02_P2.54mm_Vertical
J5: Tápcsatlakozó; TerminalBlock_4Ucon_1x02_P3.50mm_Horizontal
J6: Szolenoid 1; PinHeader_1x02_P2.54mm_Vertical
J7: Egyéb; PinHeader_1x05_P2.54mm_Vertical
J8: Szolenoid 2; PinHeader_1x02_P2.54mm_Vertical
J9: Szolenoid 3; PinHeader_1x02_P2.54mm_Vertical
J10: Szolenoid 4; PinHeader_1x02_P2.54mm_Vertical
J11: Szolenoid 5; PinHeader_1x02_P2.54mm_Vertical
J12: HC-SR04; PinHeader_1x04_P2.54mm_Vertical
K1, K2, K3, K4, K5: G2RL-1; Relay_SPDT_Omron_G2RL-1
Q1, Q2, Q3, Q4, Q5: NPN; TO-92L_Inline_Wide
R1, R2, R3, R4, R6, R7: 1k; R_Axial_DIN0207_L6.3mm_D2.5mm_P7.62mm_Horizontal
R5, R8, R9, R10, R11, R12: 330R; R_Axial_DIN0207_L6.3mm_D2.5mm_P7.62mm_Horizontal
SW1: SW_SPST; PinHeader_1x02_P2.54mm_Vertical
SW2: SW_Push; PinHeader_1x02_P2.54mm_Vertical
U1: ESP32-WROOM-32; ESP-WROOM-32
U2: Mini 560 Pro; Mini 560 PRO buck converter
U3: PinHeader_1x04_P2.54mm_Vertical
U4: DS1302 module

Connections:
+3.3V: J12.1, SW2.1, U1.16 (3.3v), U3.1 (VIN), U4.1 (VCC)
+5V: U1.15 (VIN), U2.4 (+_out)
+12V: J1.1, SW1.1 (A)
+12VA: D1.1 (K), D2.1 (K), D3.1 (K), D4.1 (K), D6.1 (K), D16.1 (K), K1.11, K1.A1, K2.11, K2.A1, K3.11, K3.A1, K4.11, K4.A1, K5.11, K5.A1, U2.1 (+_in)
BUZZER: BZ1.1 (+), U1.18 (GPIO15)
Earth: BZ1.2 (-), D5.1 (K), J1.2, J12.4, Q1.3 (E), Q2.3 (E), Q3.3 (E), Q4.3 (E), Q5.3 (E), R1.1, R8.2, R9.2, R10.2, R11.2, R12.2, U1.14 (GND), U1.17 (GND), U2.2 (-_in), U2.3 (-_out), U3.2 (GND), U4.2 (GND)
Echo: J12.3, U1.20 (GPIO4)
Gomb: R1.2, SW2.2, U1.23 (GPIO5)
HIBA: R5.1, U1.30 (GPIO23)
I2C SCL: U1.29 (GPIO22), U3.3 (SCL)
I2C SDA: U1.26 (GPIO21), U3.4 (SDA)
unnamed: D1.2 (A), K1.A2, Q1.1 (C)
unnamed: D2.2 (A), K2.A2, Q2.1 (C)
unnamed: D3.2 (A), K3.A2, Q3.1 (C)
unnamed: D4.2 (A), K4.A2, Q4.1 (C)
unnamed: D5.2 (A), R5.2
unnamed: D6.2 (A), K5.A2, Q5.1 (C)
unnamed: D11.1 (K), R8.1
unnamed: D12.1 (K), R9.1
unnamed: D13.1 (K), R10.1
unnamed: D14.1 (K), R11.1
unnamed: D15.1 (K), R12.1
unnamed: D16.2 (A), SW1.2 (B)
unnamed: J6.1, K1.12
unnamed: J6.2, K1.14
unnamed: J7.1, U1.9 (GPIO26)
unnamed: J7.2, U1.10 (GPIO27)
unnamed: J7.3, U1.11 (GPIO14)
unnamed: J7.4, U1.12 (GPIO12)
unnamed: J7.5, U1.13 (GPIO13)
unnamed: J8.1, K2.12
unnamed: J8.2, K2.14
unnamed: J9.1, K3.12
unnamed: J9.2, K3.14
unnamed: J10.1, K4.12
unnamed: J10.2, K4.14
unnamed: J11.1, K5.12
unnamed: J11.2, K5.14
unnamed: Q1.2 (B), R2.2
unnamed: Q2.2 (B), R3.2
unnamed: Q3.2 (B), R4.2
unnamed: Q4.2 (B), R6.2
unnamed: Q5.2 (B), R7.2
RTC_CLK: U1.8 (GPIO25), U4.3 (CLK)
RTC_DAT: U1.7 (GPIO33), U4.4 (DAT)
RTC_RST: U1.6 (GPIO32), U4.5 (RST)
Szolenoid 1: D7.2 (A), D11.2 (A), R2.1, U1.25 (GPIO19)
Szolenoid 2: D8.2 (A), D12.2 (A), R3.1, U1.24 (GPIO18)
Szolenoid 3: D9.2 (A), D13.2 (A), R4.1, U1.22 (GPIO17)
Szolenoid 4: D10.2 (A), D14.2 (A), R6.1, U1.21 (GPIO16)
Szolenoid 5: D7.1 (K), D8.1 (K), D9.1 (K), D10.1 (K), D15.2 (A), R7.1
Talajnedvesség 1: J3.1, U1.2 (GPIO36)
Talajnedvesség 2: J3.2, U1.3 (GPIO39)
Talajnedvesség 3: J4.1, U1.4 (GPIO34)
Talajnedvesség 4: J4.2, U1.5 (GPIO35)
Trig: J12.2, U1.19 (GPIO2)

Notes on the sheet:
Hiba visszajelzés
Gomb
Mikrovezérlő
Buzzer
4 zónás öntözőberendezés
Csatlakozók
Bosch BME280
Relék
Táp
RTC

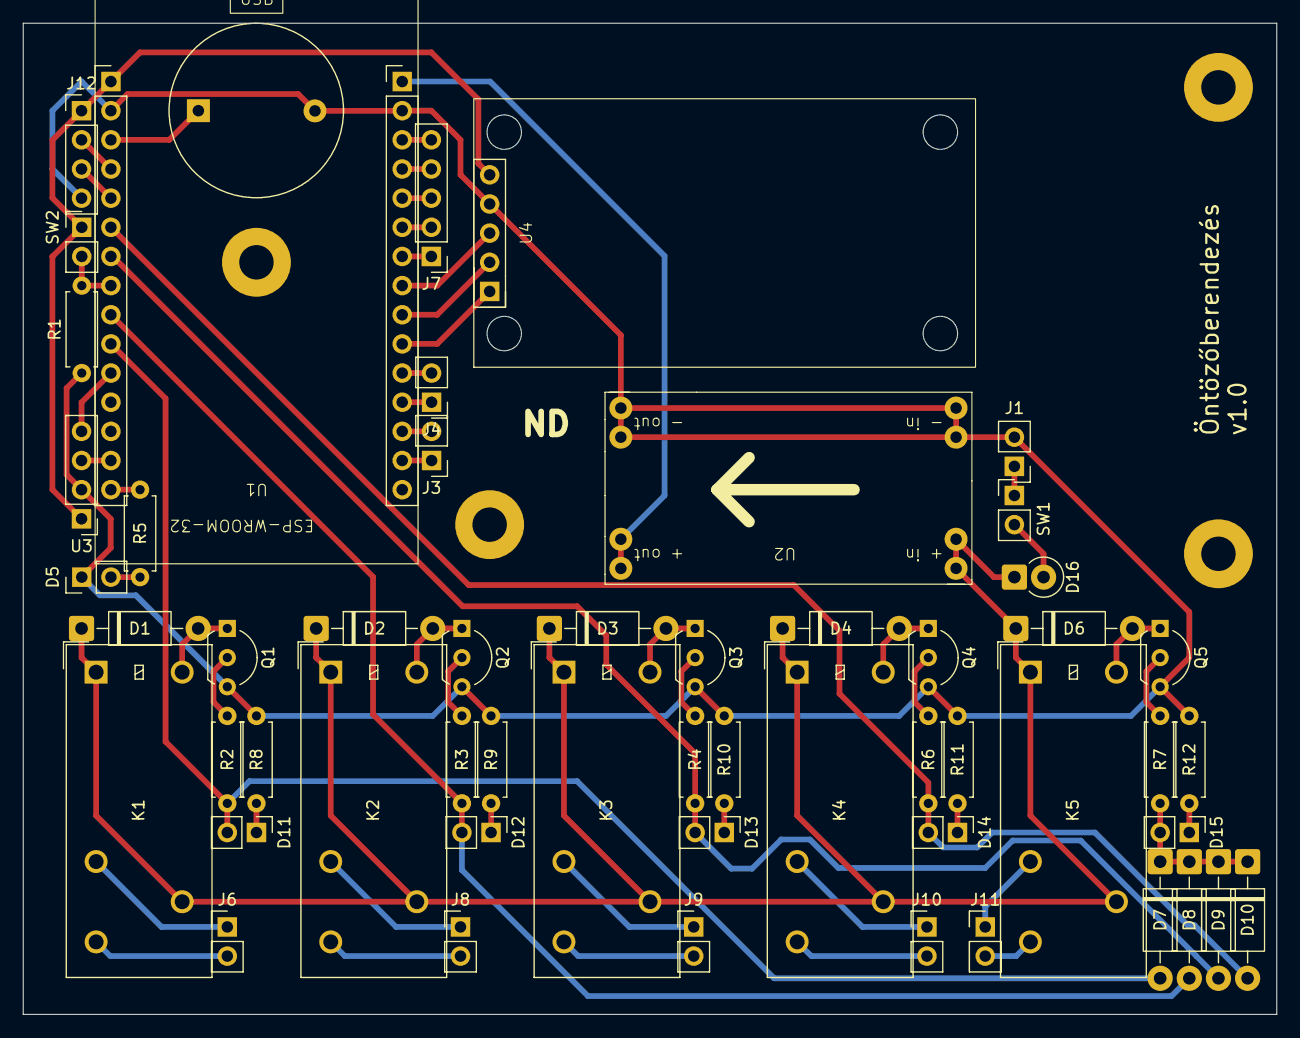
[picture p24: board Öntözőberendezés.kicad_pcb from above]

Board: 2 copper layers, 109.2 x 86.4 mm, 55 parts (0 on the bottom side), 56 nets.
