CITROMOSEPER/4-zone-irrigation-system-2026-TDK-Project/Arduino - discontinued/Ontozoberendezes/PINS.h

#define HUMIDITY_1_PIN 36
#define HUMIDITY_2_PIN 39
#define HUMIDITY_3_PIN 34
#define HUMIDITY_4_PIN 35

#define ULTRASONIC_TRIG_PIN 2
#define ULTRASONIC_ECHO_PIN 4

#define BUTTON_PIN 5


#define SOLENOID_1_PIN 19
#define SOLENOID_2_PIN 18
#define SOLENOID_3_PIN 17
#define SOLENOID_4_PIN 16

#define ERROR_LED_PIN 23

#define SCL_PIN 22
#define SDA_PIN 21


#define RTC_CLK_PIN 25
#define RTC_DAT_PIN 33
#define RTC_RST_PIN 32


#define BUZZER_PIN 15
