CITROMOSEPER/4-zone-irrigation-system-2026-TDK-Project/Final PlatformIO code/Irrigation system/src/logic/Alerts.cpp

#include "logic/Alerts.h"
#include <WiFi.h>
#include "System.h"

void Alerts::check(Flag& f, bool now) {
  if (now != f.raw) { f.raw = now; f.since = millis(); }
  if (f.raw == f.logged || !elapsed(f.since, f.debounceS * 1000UL)) return;
  f.logged = f.raw;
  char code[16];
  // Codes as the UI knows them: TANK_LOW / TANK_OK, ENV / ENV_OK, ...
  if (f.raw) snprintf(code, sizeof(code), "%s", strcmp(f.code, "TANK") ? f.code : "TANK_LOW");
  else snprintf(code, sizeof(code), "%s_OK", f.code);
  sys.log.alert(f.zone, code, f.raw ? f.level : 'I');
}

void Alerts::update() {
  if (!elapsed(_tick, 1000)) return;
  _tick = millis();
  if (!_init) {
    _init = true;
    for (uint8_t z = 0; z < ZONES; z++) {
      _f[SYS + z] = Flag{"SOIL", 'W', (uint8_t)(z + 1), 60, false, false, 0};
      _f[SYS + ZONES + z] = Flag{"NORISE", 'W', (uint8_t)(z + 1), 0, false, false, 0};
    }
  }
  check(_f[0], sys.tank.low());
  check(_f[1], !sys.env.valid());
  check(_f[2], sys.water.faulted());
  check(_f[3], !sys.clock.valid());
  // Wi-Fi: only a lost connection or a signal too weak to use, and only when it lasts (WIFI_ALERT_S)
  bool sta = sys.net.mode() == WifiPortal::Mode::STA;
  check(_f[4], sta && (!sys.net.connected() || WiFi.RSSI() < WIFI_UNUSABLE_RSSI));
  check(_f[5], !sys.wx.fresh());
  check(_f[6], !sys.env.valid() && !isnan(sys.wx.tempAt(sys.clock.unixNow())));
  check(_f[7], !sys.clock.rtcOk() && sys.clock.valid());
  for (uint8_t z = 0; z < ZONES; z++) {
    const ZoneCfg& c = sys.cfg.z[z];
    check(_f[SYS + z], c.en && sys.soil[z].fault());
    check(_f[SYS + ZONES + z], c.en && c.m == (uint8_t)ZoneMode::CLOSED_LOOP && !sys.soil[z].fault() && sys.dose.noRise(z));
  }
}
